UVicFormulaMotorsport/CANwheel/README.md

# CANwheel
CAN steering wheel control unit
