UVicFormulaMotorsport/CANwheel/hardware/release/UV17-A/CANwheel-Schematics-UV17_A.PDF

## Title Page

CANwheel | Revision: A
Date: 2017-02-19 | Sheet: 1/ 6

# CANwheel

1
2
3
4
5
6

## Title.SchDoc Power.SchDoc Microcontroller.SchDoc LEDs.SchDoc Connectors.SchDoc Mechanical.SchDoc

## Fancy title sheet Power supplies Microcontroller and peripherals LED driver and LEDs CAN, power, and I/O connectors Mounting holes, fiducials, other mechanicals

File Name | Page | Description
Revision | Date | Remarks
A | 2017-02-19 | Initial revision

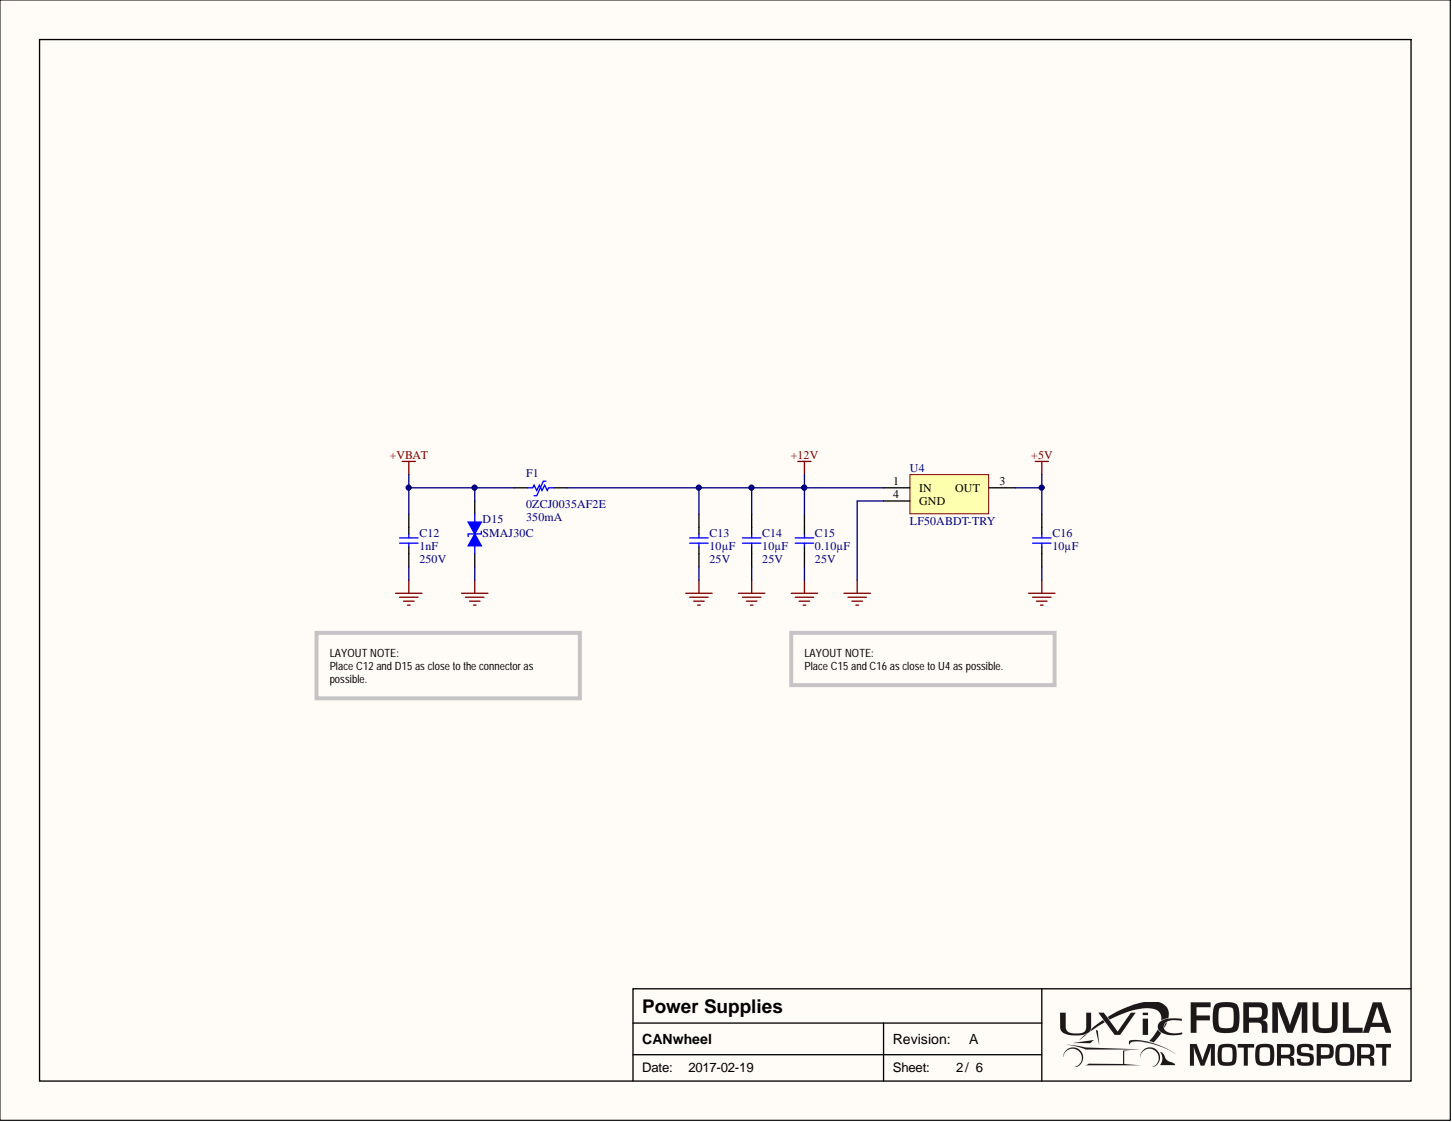
[picture p6: page 2]

LAYO
Place C12 and D15 as close to the connector as
poss

Place C15 and C16 as close to U4 as poss

Power Supplies

CANwheel Date: 2017-0 | Revision: A

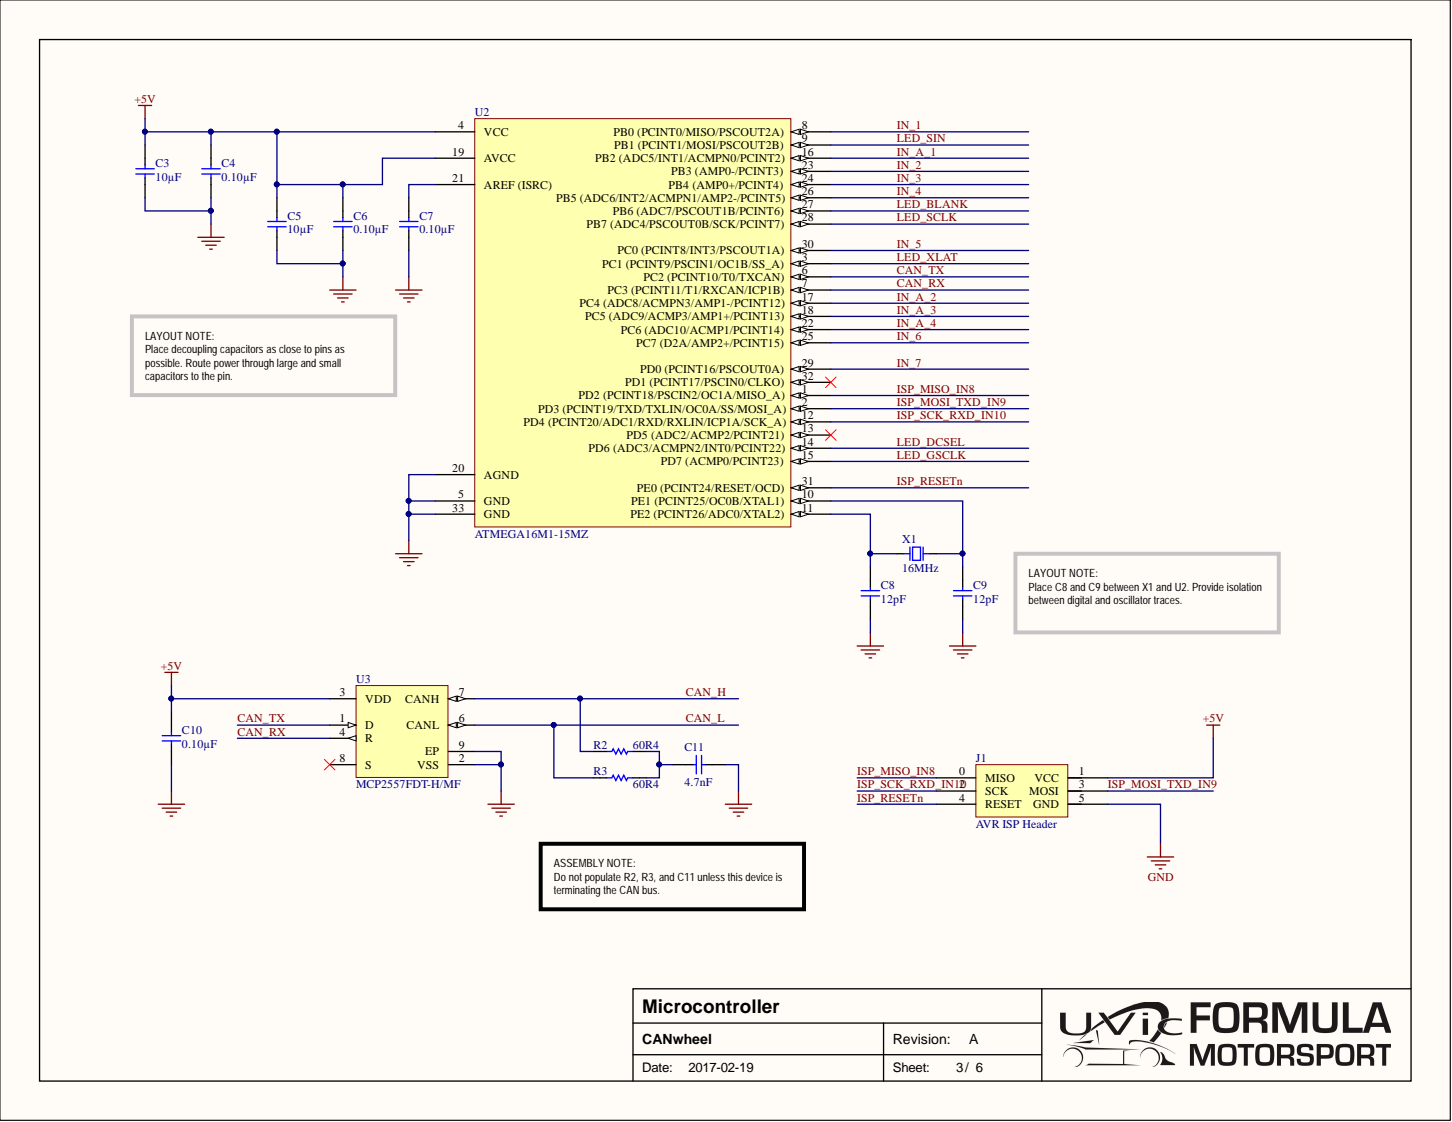
[picture p7: page 3]

LAYO
Place decoupl
poss
capacitors to the pin.

OTE:
ing capacitors as close to pins as

ible. Route power through large and smal

3 3 | 1 1

Place C8 and C9 between X1 and U2. Provide i
between digital and osci

ASSEMBLY N
Do not populate R2, R3, and C11 unless thi
terminating the CAN bus

Microcontroller

CANwheel Date: 2017-0 | Revision: A

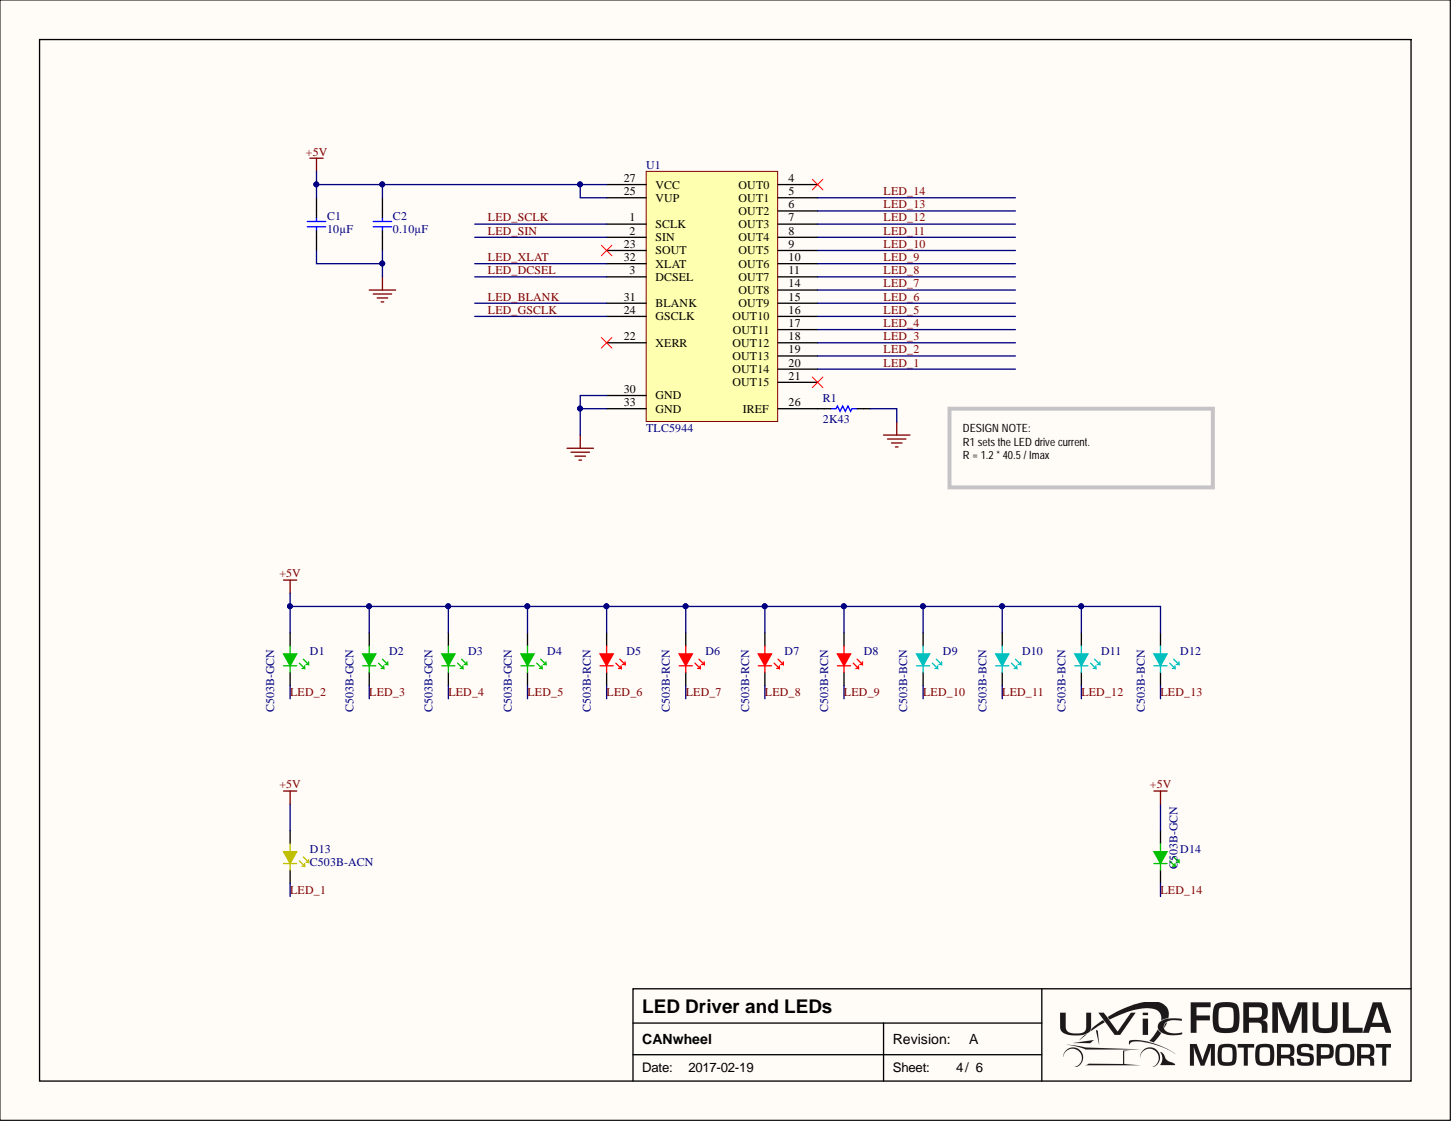
[picture p8: page 4]

DESIGN NOTE:
R1 sets the LED drive current.
R = 1.2 * 40.5 / Imax

LED Driver and LEDs

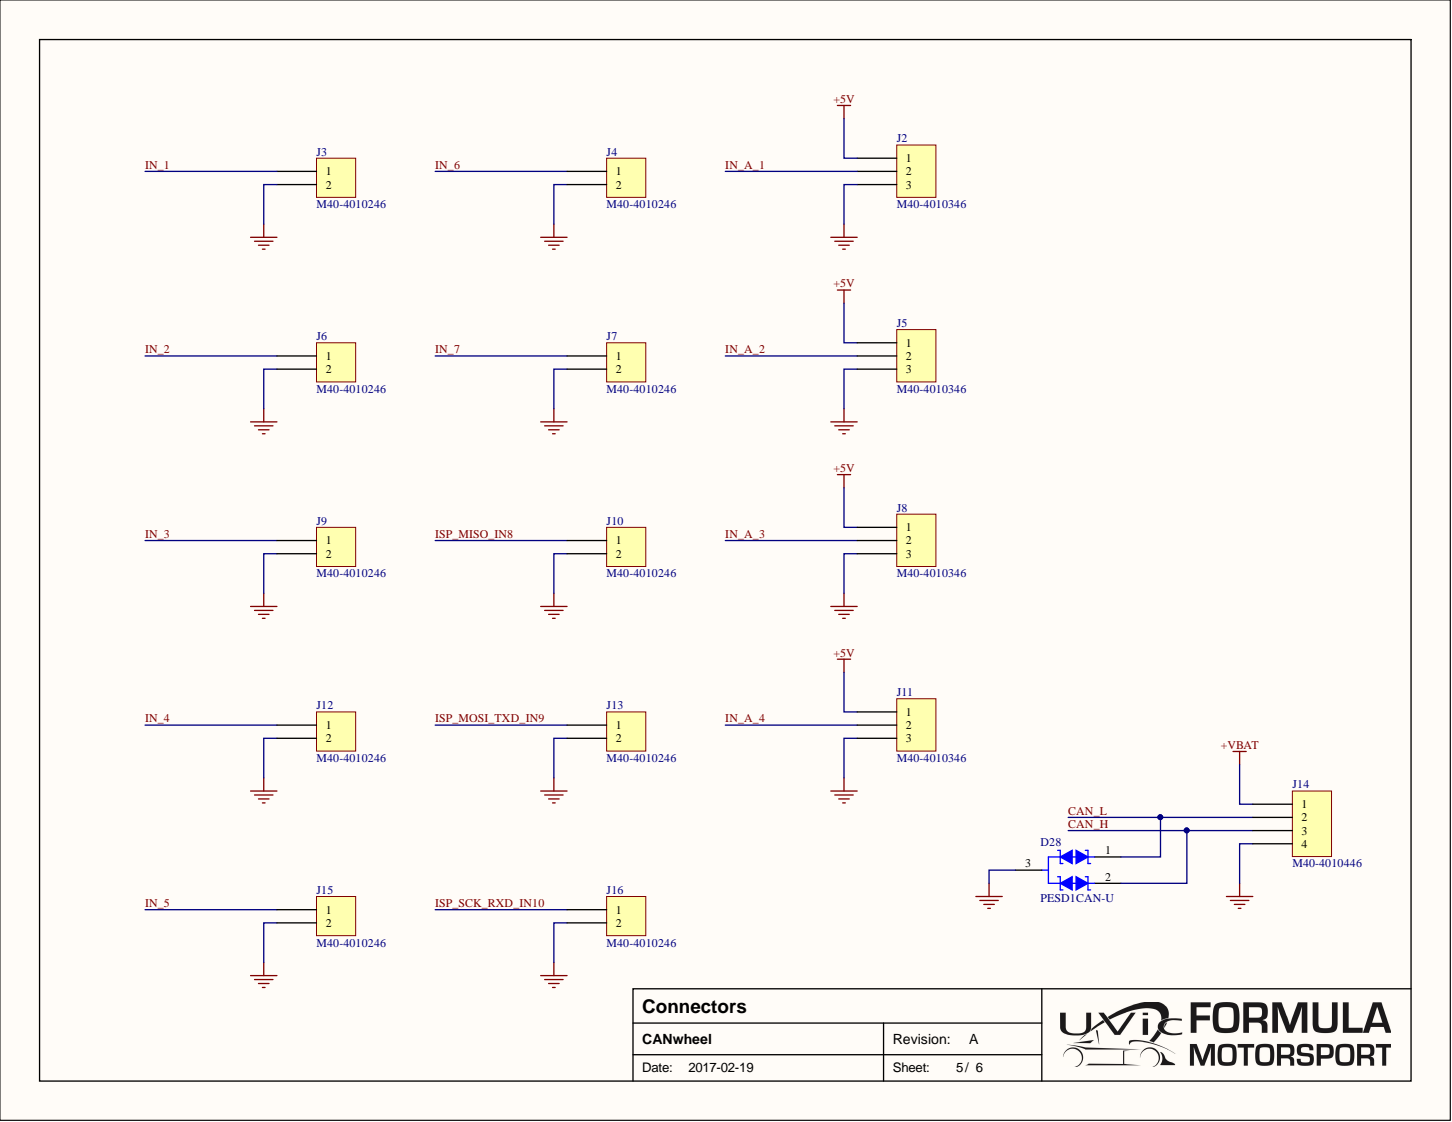
[picture p9: page 5]

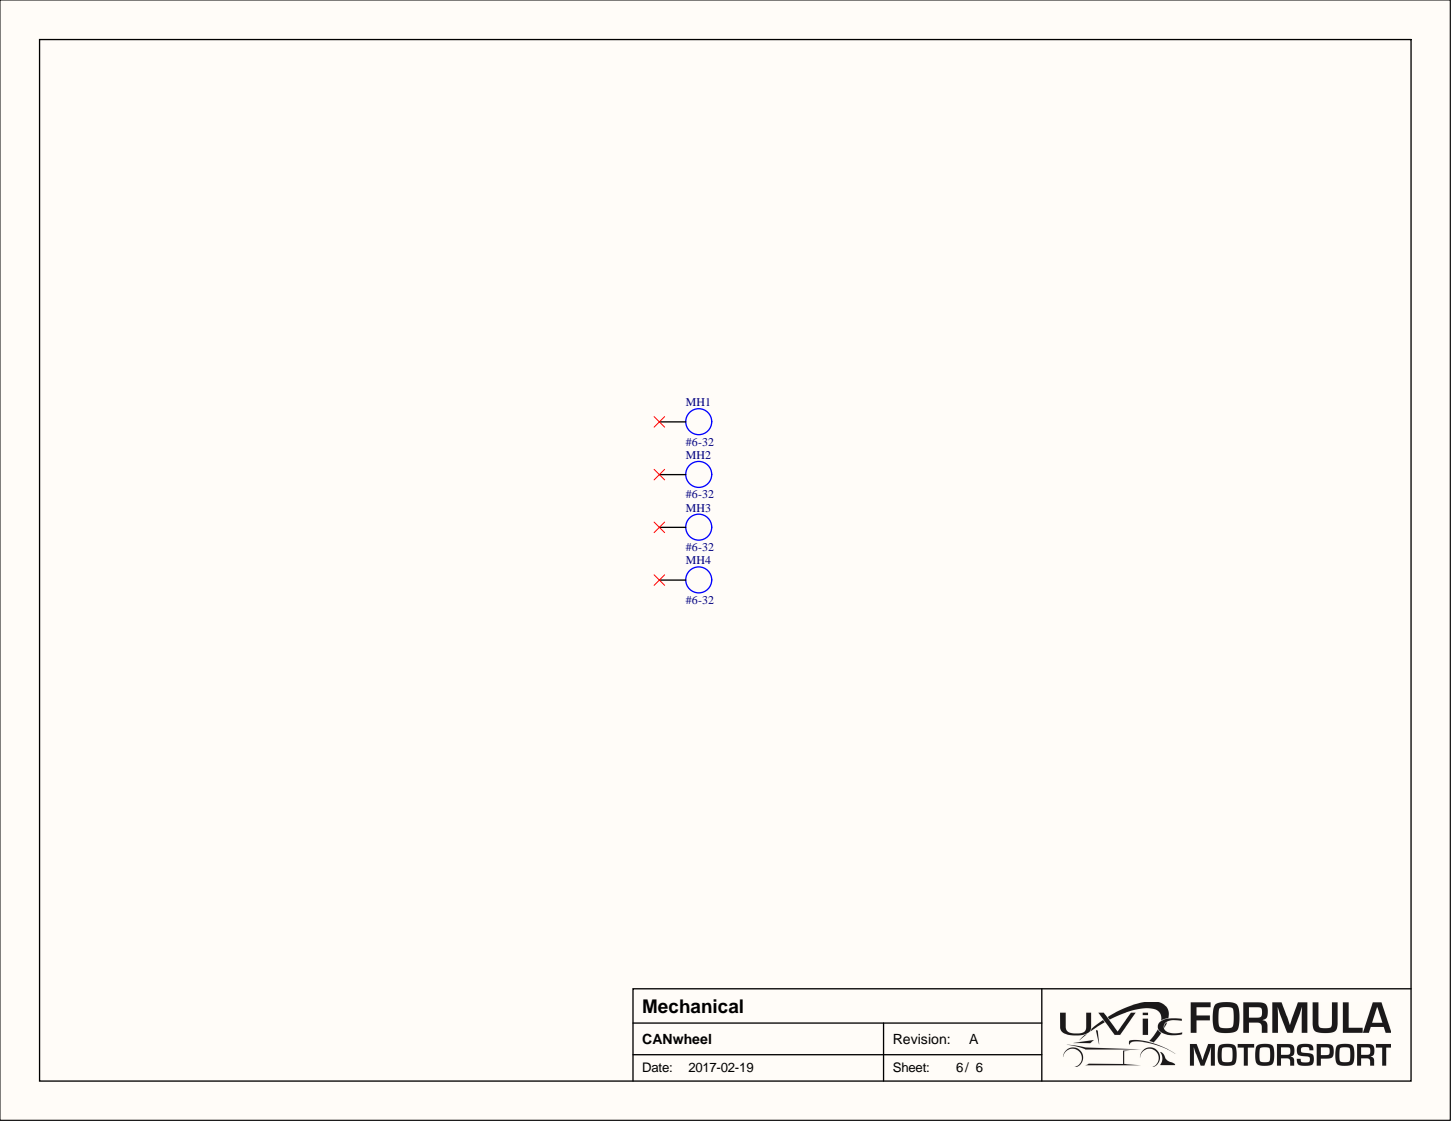
[picture p10: page 6]
