UVicFormulaMotorsport/CANwheel/(list of files, drawings)

Other design files:
hardware/design/CANwheel.PcbDoc
hardware/design/CANwheel.PcbLib
hardware/design/CANwheel.PrjPcb
hardware/design/CANwheel.SchLib
hardware/design/Connectors.SchDoc
hardware/design/LEDs.SchDoc
hardware/design/Mechanical.SchDoc
hardware/design/Microcontroller.SchDoc
hardware/design/Power.SchDoc
hardware/design/Title.SchDoc
