UVicFormulaMotorsport/CANwheel/(commit log)

2017-01-09 Add firmware framework
2017-02-20 Add UV17 revision A hardware design
    [CANwheel.GBL, CANwheel.GBO, CANwheel.GBS, CANwheel.GKO, CANwheel.GM1, CANwheel.GTL, CANwheel.GTO, CANwheel.GTS]
2017-02-20 Add LED driver datasheet
2017-03-12 Add BOM
    [Bill of Materials-CANwheel.csv, CANwheel.PrjPcb]
2017-04-13 Added UV17 revision B hardware design
    Switched to QFP packages, replaced CAN transceiver, replaced tiny
    connectors with larger ones and simple wire-to-board holes.
    [Bill of Materials-CANwheel.csv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]
